electrovir/byu_baja/README.md

# BYU BAJA Instrumentation

This is the code, documentation, and tests for the BYU BAJA instrumentation effort.

More documentation has been made than what is presently shown, but it has not all been prepared for public presentation yet.
