electrovir/byu_baja/documentation/complete_circuit/arduino-publicdomain.png

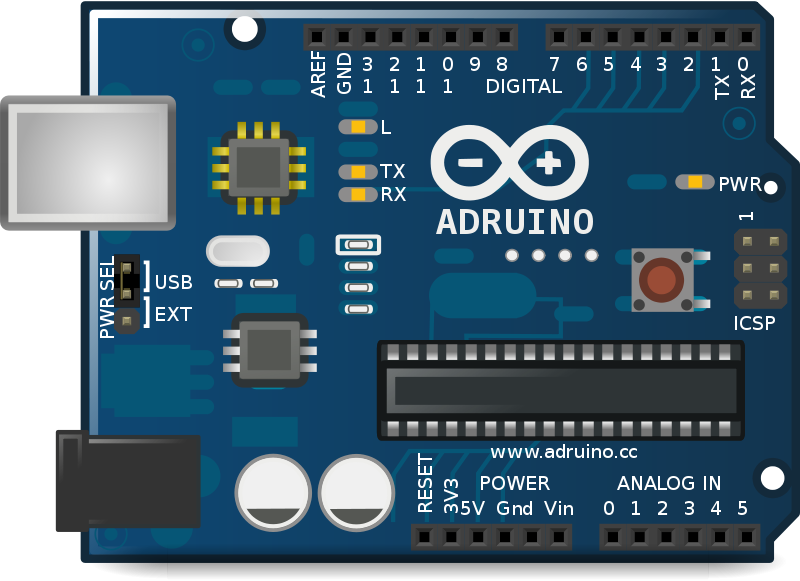
documentation/complete_circuit/arduino-publicdomain.png
