electrovir/byu_baja/documentation/complete_circuit/assembled.md

# Assembled

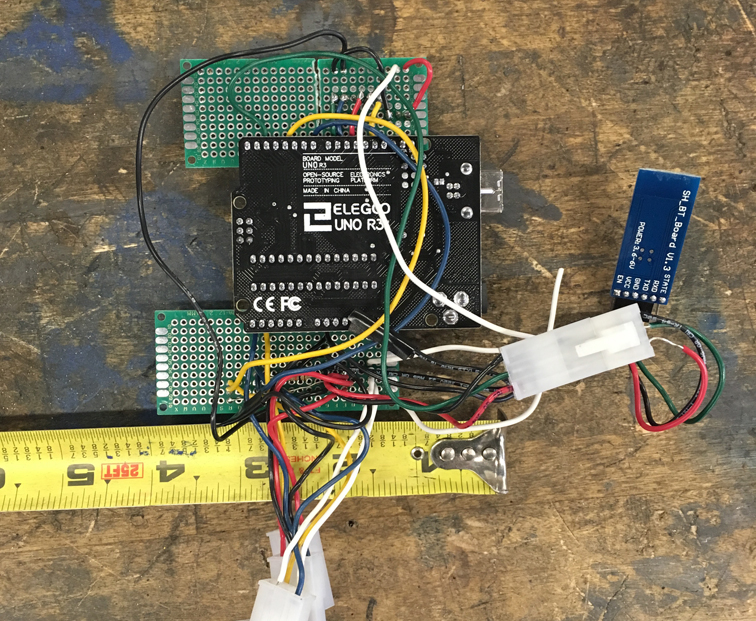
[picture p21: documentation/complete_circuit/assembled_1.jpg]


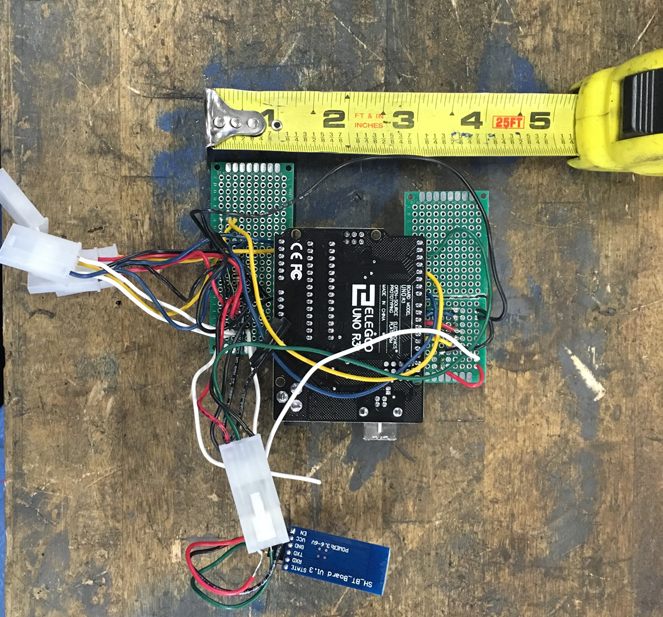
[picture p22: documentation/complete_circuit/assembled_2.jpg]


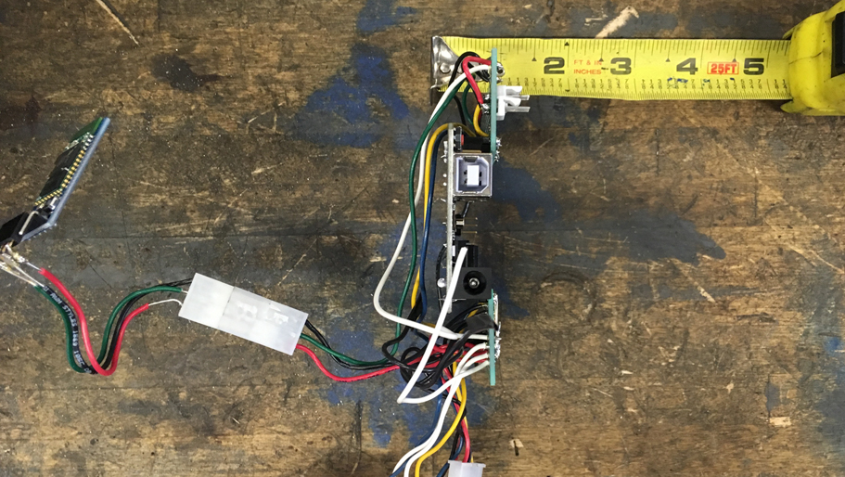
[picture p23: documentation/complete_circuit/assembled_3.jpg]
