electrovir/byu_baja/documentation/tests/rf_range_test/firstRfRangeTest.txt

Now sending 388771...ok...Got response 388771, round-trip delay: 23

Now sending 389794...ok...Got response 389794, round-trip delay: 23

Now sending 390817...ok...Got response 390817, round-trip delay: 23

Now sending 391840...ok...Got response 391840, round-trip delay: 24

Now sending 392864...ok...Got response 392864, round-trip delay: 23

Now sending 393887...ok...Got response 393887, round-trip delay: 23

Now sending 394910...ok...Got response 394910, round-trip delay: 23

Now sending 395933...ok...Got response 395933, round-trip delay: 24

Now sending 396957...ok...Got response 396957, round-trip delay: 23

Now sending 397980...ok...Got response 397980, round-trip delay: 23

Now sending 399003...ok...Got response 399003, round-trip delay: 23

Now sending 400026...ok...Got response 400026, round-trip delay: 24

Now sending 401050...ok...Got response 401050, round-trip delay: 23

Now sending 402073...ok...Got response 402073, round-trip delay: 23

Now sending 403096...ok...Got response 403096, round-trip delay: 36

Now sending 404133...ok...Got response 404133, round-trip delay: 23

Now sending 405156...ok...Got response 405156, round-trip delay: 23

Now sending 406179...ok...Got response 406179, round-trip delay: 23

Now sending 407202...ok...Got response 407202, round-trip delay: 23

Now sending 408226...ok...Got response 408226, round-trip delay: 23

Now sending 409249...ok...Got response 409249, round-trip delay: 23

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

Now sending 1024484...ok...Got response 1024484, round-trip delay: 22

Now sending 1025507...ok...Got response 1025507, round-trip delay: 22

Now sending 1026531...ok...Got response 1026531, round-trip delay: 22

Now sending 1027554...ok...Got response 1027554, round-trip delay: 40

Now sending 1028595...ok...Got response 1028595, round-trip delay: 32

Now sending 1029627...ok...Got response 1029627, round-trip delay: 54

Now sending 1030682...ok...Got response 1030682, round-trip delay: 53

Now sending 1031736...ok...Got response 1031736, round-trip delay: 81

Now sending 1032817...ok...Got response 1032817, round-trip delay: 50

Now sending 1033868...ok...Got response 1033868, round-trip delay: 22

Now sending 1034891...ok...Got response 1034891, round-trip delay: 22

Now sending 1035914...ok...Got response 1035914, round-trip delay: 23

Now sending 1036938...ok...Got response 1036938, round-trip delay: 22

Now sending 1037961...ok...Got response 1037961, round-trip delay: 31

Now sending 1038993...ok...Got response 1038993, round-trip delay: 32

Now sending 1040025...ok...Got response 1040025, round-trip delay: 36

**************MARKER**************
Now sending 1041062...ok...Got response 1041062, round-trip delay: 23

marker value: back at laptop

Now sending 1042086...ok...Got response 1042086, round-trip delay: 23

Now sending 1043109...ok...Got response 1043109, round-trip delay: 23

Now sending 1044132...ok...Got response 1044132, round-trip delay: 23

Now sending 1045155...ok...Got response 1045155, round-trip delay: 24

Now sending 1046179...ok...Got response 1046179, round-trip delay: 32

Now sending 1047212...ok...Got response 1047212, round-trip delay: 22

Now sending 1048235...ok...Got response 1048235, round-trip delay: 35

Now sending 1049271...ok...Got response 1049271, round-trip delay: 23

Now sending 1050295...ok...Got response 1050295, round-trip delay: 22
