electrovir/byu_baja/documentation/tests/speedotachometer_car_dyno/test.xls

Speed (mph)
6.544531
6.544531
6.481743
6.481743
6.485672
6.485672
6.432652
6.432652
6.232306
6.232306
6.109903
6.109903
6.109903
6.014713
6.014713
5.991411
5.991411
5.953413
5.953413
5.761488
5.761488
5.761488
5.598954
5.598954
5.492403
5.492403
5.399186
5.399186
5.399186
5.359169
5.359169
5.185294
5.185294
5.185294
4.995247
4.995247
4.995247
4.853342
4.853342
4.733469
4.733469
4.733469
4.667
4.667
4.667
4.535275
4.535275
4.535275
4.325354
4.325354
4.325354
4.159716
4.159716
4.159716
4.024738
4.024738
4.024738
4.024738
3.932626
3.932626
3.932626
3.824246
3.824246
3.824246
3.824246
3.649589
3.649589
3.649589
3.649589
3.519759
3.519759
3.519759
3.415555
3.415555
3.415555
3.415555
3.376117
3.376117
3.376117
3.376117
3.345384
3.345384
3.345384
3.345384
3.314795
3.314795
3.314795
3.576313
3.576313
3.576313
3.576313
3.959573
3.959573
4.350675
4.350675
4.759913
4.759913
5.034255
5.034255
5.034255
5.267684
5.267684
5.52564
5.52564
5.809907
6.143293
6.143293
6.372438
6.372438
6.475154
6.475154
6.650602
6.834775
6.834775
7.105421
7.105421
7.314244
7.314244
7.355468
7.355468
7.47424
7.629407
7.629407
7.885071
7.885071
8.128963
8.173916
8.173916
8.232774
8.232774
8.395004
8.586573
8.586573
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
