electrovir/byu_baja/documentation/tests/driving_tests/2018-03-30_no_magnet_test/data/mini_run_4_original.csv

84 | 6 | 0 | 0 | 0 | 0 | true | 1522445383
885 | 7 | 0 | 0 | 0 | 0 | true | 1522445383
900 | 7 | 0 | 0 | 0 | 0 | true | 1522445383
901 | 6 | 0 | 0 | 0 | 0 | true | 1522445383
902 | 6 | 0 | 0 | 0 | 0 | true | 1522445383
903 | 7 | 0 | 0 | 0 | 0 | true | 1522445383
908 | 6 | 0 | 0 | 0 | 0 | true | 1522445383
909 | 7 | 0 | 0 | 0 | 0 | true | 1522445383
910 | 6 | 0 | 0 | 0 | 0 | true | 1522445383
911 | 6 | 0 | 0 | 0 | 0 | true | 1522445383
 | 6 | 0 | 0 | 0 | 0 | true | 1522445383
948 | 6 | 0 | 0 | 0 | 0 | true | 1522445383
949 | 6 | 0 | 0 | 0 | 0 | true | 1522445383
950 | 6 | 0 | 0 | 0 | 0 | true | 1522445383
 | 6 | 0 | 0 | 0 | 0 | true | 1522445384
952 | 7 | 0 | 0 | 0 | 0 | true | 1522445384
953 | 6 | 0 | 0 | 0 | 0 | true | 1522445384
954 | 6 | 0 | 0 | 0 | 0 | true | 1522445384
55 | 6 | 0 | 0 | 0 | 0 | true | 1522445384
956 | 6 | 0 | 0 | 0 | 0 | true | 1522445384
957 | 6 | 0 | 0 | 0 | 0 | true | 1522445384
958 | 6 | 0 | 0 | 0 | 0 | true | 1522445384
95 | 6 | 0 | 0 | 0 | 0 | true | 1522445384
996 | 6 | 0 | 0 | 0 | 0 | true | 1522445384
997 | 6 | 0 | 0 | 0 | 0 | true | 1522445384
9 | 6 | 0 | 0 | 0 | 0 | true | 1522445384
0 | 6 | 0 | 0 | 0 | 0 | true | 1522445384
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
