electrovir/byu_baja/documentation/tests/lego_tachometer/lego_pickup_closeup.jpg

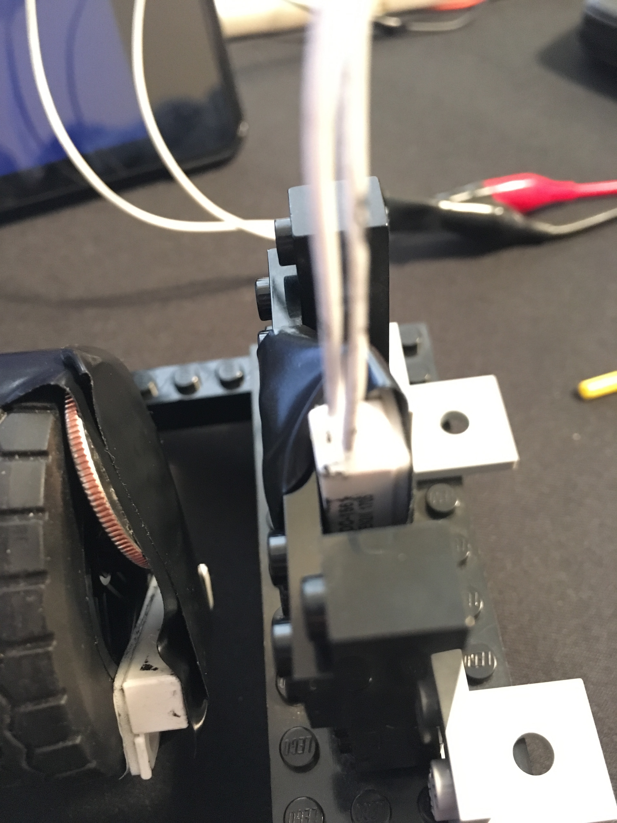
documentation/tests/lego_tachometer/lego_pickup_closeup.jpg
