electrovir/byu_baja/documentation/tests/lego_tachometer/lego_wheel_closeup.jpg

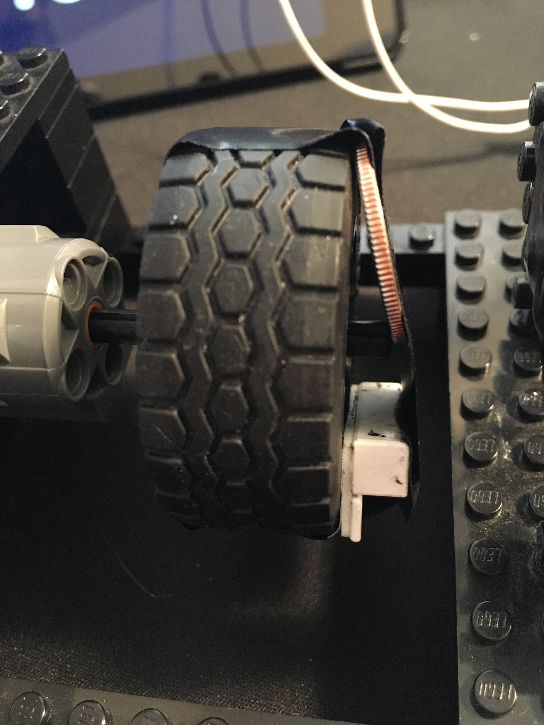
documentation/tests/lego_tachometer/lego_wheel_closeup.jpg
