electrovir/byu_baja/documentation/speedotachometer/speedometerCircuit.asc

pullDownR: res; 10K
Sensor: csw; ""
X1: arduino
X2: bluetooth
Arduino
Bluetooth
