electrovir/byu_baja/documentation/tests/rf_range_test/code.ino

#include <SPI.h>
#include <EEPROM.h>
#include "nRF24L01.h"
#include "RF24.h"
#include "printf.h"

// FIXME: include these in a header file instead of here
#define ALPHA_ID 42
#define BETA_ID 27

String inputString = "";         // a String to hold incoming data
boolean stringComplete = false;  // whether the string is complete

//
// Hardware configuration
//

// Set up nRF24L01 radio on SPI bus plus pins 9 & 10 

RF24 radio(9,10);

//
// Topology
//

// Radio pipe addresses for the 2 nodes to communicate.
const uint64_t pipes[2] = { 0xF0F0F0F0E1LL, 0xF0F0F0F0D2LL };

//
// Role management
//
// Set up role.  This sketch uses the same software for all the nodes
// in this system.  Doing so greatly simplifies testing.  
//

// The various roles supported by this sketch
typedef enum { ROLE_SEND_PING = 1, ROLE_RESPOND_PONG } role_e;

// The debug-friendly names of those roles
const char* role_friendly_name[] = { "invalid", "Ping out", "Pong back"};

// The role of the current running sketch
role_e role = ROLE_RESPOND_PONG;

void setup(void)
{
  //
  // Print preamble
  //

  Serial.begin(57600);
  printf_begin();
  printf("\n\rRF24/examples/GettingStarted/\n\r");
  printf("ROLE: %s\n\r",role_friendly_name[role]);
  printf("*** PRESS 'T' to begin transmitting to the other node\n\r");

  //
  // Setup and configure rf radio
  //

  radio.begin();

  // optionally, increase the delay between retries & # of retries
  radio.setRetries(15,15);

  // optionally, reduce the payload size.  seems to
  // improve reliability
  //radio.setPayloadSize(8);

  //
  // Figure out which arduino this is, the alpha or the beta
  //

  if (EEPROM.read(0) == ALPHA_ID) {
    // Alpha is the transmitter
    role = ROLE_SEND_PING;
    Serial.println(">>>>>>>>>>> I AM THE ALPHA MALE <<<<<<<<<<<");
  }
  else {
    role = ROLE_RESPOND_PONG;
    Serial.println("........... i'm just a little beta ...........");
  }

  //
  // Open pipes to other nodes for communication
  //

  // This simple sketch opens two pipes for these two nodes to communicate
  // back and forth.
  // Open 'our' pipe for writing
  // Open the 'other' pipe for reading, in position #1 (we can have up to 5 pipes open for reading)

  if ( role == ROLE_SEND_PING )
  {
    radio.openWritingPipe(pipes[0]);
    radio.openReadingPipe(1,pipes[1]);
  }
  else
  {
    radio.openWritingPipe(pipes[1]);
    radio.openReadingPipe(1,pipes[0]);
  }

  //
  // Start listening
  //

  radio.startListening();

  //
  // Dump the configuration of the rf unit for debugging
  //

  radio.printDetails();
}

void loop(void)
{
  //
  // Ping out role.  Repeatedly send the current time
  //

  if (role == ROLE_SEND_PING)
  {
    // First, stop listening so we can talk.
    radio.stopListening();

    // Take the time, and send it.  This will block until complete
    unsigned long time = millis();
    printf("Now sending %lu...",time);
    bool ok = radio.write( &time, sizeof(unsigned long) );
    
    if (ok)
      printf("ok...");
    else
      printf("failed.\n\r");

    // Now, continue listening
    radio.startListening();

    // Wait here until we get a response, or timeout (250ms)
    unsigned long started_waiting_at = millis();
    bool timeout = false;
    while ( ! radio.available() && ! timeout )
      if (millis() - started_waiting_at > 200 )
        timeout = true;

    // Describe the results
    if ( timeout )
    {
      printf("Failed, response timed out.\n\r");
    }
    else
    {
      // Grab the response, compare, and send to debugging spew
      unsigned long got_time;
      radio.read( &got_time, sizeof(unsigned long) );

      // Spew it
      printf("Got response %lu, round-trip delay: %lu\n\r",got_time,millis()-got_time);
    }

    // Try again 1s later
    delay(1000);
  }

  //
  // Pong back role.  Receive each packet, dump it out, and send it back
  //

  if ( role == ROLE_RESPOND_PONG )
  {
    // if there is data ready
    if ( radio.available() )
    {
      // Dump the payloads until we've gotten everything
      unsigned long got_time;
      bool done = false;
      while (!done)
      {
        // Fetch the payload, and see if this was the last one.
        done = radio.read( &got_time, sizeof(unsigned long) );

        // Spew it
        printf("Got payload %lu...",got_time);

	// Delay just a little bit to let the other unit
	// make the transition to receiver
	delay(20);
      }

      // First, stop listening so we can talk
      radio.stopListening();

      // Send the final one back.
      radio.write( &got_time, sizeof(unsigned long) );
      printf("Sent response.\n\r");

      // Now, resume listening so we catch the next packets.
      radio.startListening();
    }
  }

  //
  // Print markers
  //
  if (stringComplete) {
    Serial.println("");
    Serial.println("marker value: " + inputString);
    Serial.println("");
    // clear the string:
    inputString = "";
    stringComplete = false;
  }

  
//  if ( Serial.available() )
//  {
//    char c = toupper(Serial.read());
//    Serial.println("**************MARKER**************");
//    Serial.println();
//    if ( c == 'T' && role == ROLE_RESPOND_PONG )
//    {
//      printf("*** CHANGING TO TRANSMIT ROLE -- PRESS 'R' TO SWITCH BACK\n\r");
//
//      // Become the primary transmitter (ping out)
//      role = ROLE_SEND_PING;
//      radio.openWritingPipe(pipes[0]);
//      radio.openReadingPipe(1,pipes[1]);
//    }
//    else if ( c == 'R' && role == ROLE_SEND_PING )
//    {
//      printf("*** CHANGING TO RECEIVE ROLE -- PRESS 'T' TO SWITCH BACK\n\r");
//      
//      // Become the primary receiver (pong back)
//      role = ROLE_RESPOND_PONG;
//      radio.openWritingPipe(pipes[1]);
//      radio.openReadingPipe(1,pipes[0]);
//    }
//  }
}

void serialEvent() {
  Serial.println("**************MARKER**************");
  while (Serial.available()) {
    // get the new byte:
    char inChar = (char)Serial.read();
    // add it to the inputString:
    inputString += inChar;
    // if the incoming character is a newline, set a flag so the main loop can
    // do something about it:
    if (inChar == '\n') {
      stringComplete = true;
    }
  }
}

// vim:cin:ai:sts=2 sw=2 ft=cpp
