electrovir/byu_baja/(commit log)

2018-01-12 Android and Arduino code
2018-01-19 added shock sensor reading
2018-01-26 throttled bluetooth transmission frequency, included test explanation for why
2018-01-26 added notes for shock sensor
2018-02-06 added circuitry documentation
2018-02-12 changed arduino output to JSON
2018-02-23 moved, finished first drive test report
    [sage_long.csv]
2018-03-02 added ability to record subsets of incoming data into individual files with start/stop button
2018-03-05 renamed folders to match proper file naming scheme
    [sage_long.csv]
2018-03-05 adding gitignore, which currently just ignores movie files (they're huge)
2018-03-09 updated circuit to include 2 more suspension potentiometers
2018-03-26 adding all documentation, working on finalizing it all
    [test.xls]
2018-04-02 Added driving test results from march 30
    [mini_run_3.csv, mini_run_4.csv, mini_run_4_original.csv]
2018-04-16 added how to guide on using the Android and Arduino
